AYUSH-pro-grammer/stm-flight-controller/bom.csv

Reference | Component | Quantity | Unit Price (USD) | Product Link
C1; C5 | YAGEO 10pF 0402 | 2 | 0.0213 | https://www.lcsc.com/product-detail/C3860506.html
C2 | CCTC 10uF 0805 | 1 | 0.0420 | https://www.lcsc.com/product-detail/C380331.html
C3; C7; C13; C23; C24; C28; C29 | FH 100nF 0603 | 7 | 0.0053 | https://www.lcsc.com/product-detail/C30926.html
C4; C6; C9; C11; C12; C17; C18; C19; C20; C21; C22 | FH 100nF 0603 | 11 | 0.0053 | https://www.lcsc.com/product-detail/C30926.html
C8; C10 | Samsung 2.2uF 0603 | 2 | 0.0120 | https://www.lcsc.com/product-detail/C23630.html
C14 | CCTC 10nF 0402 | 1 | 0.0057 | https://www.lcsc.com/product-detail/C688874.html
C15; C16 | SAMWHA 1uF 0603 | 2 | 0.0134 | https://www.lcsc.com/product-detail/C513775.html
C25; C26 | YAGEO 22uF 1210 | 2 | 0.5208 | https://www.lcsc.com/product-detail/C5341638.html
C27 | KEMET 220pF 0603 | 1 | 0.1150 | https://www.lcsc.com/product-detail/C3843887.html
C30 | Samsung Electro-Mechanics CL10A105KB8NNNC 1uF 50V 0603 | 1 | 0.0159 | https://www.lcsc.com/product-detail/C15849.html
C31 | YAGEO 4.7uF 0805 25V | 1 | 0.0717 | https://www.lcsc.com/product-detail/C5185457.html
C32 | FH 4.7uF 0805 25V | 1 | 0.0617 | https://www.lcsc.com/product-detail/C274413.html
C33 | CCTC 10nF 0603 | 1 | 0.0055 | https://www.lcsc.com/product-detail/C282516.html
C34 | FH 2.2nF 0603 | 1 | 0.0109 | https://www.lcsc.com/product-detail/C1604.html
C35 | YAGEO 22pF 0603 | 1 | 0.0295 | https://www.lcsc.com/product-detail/C2240294.html
C36 | YAGEO 10nF 0603 | 1 | 0.0151 | https://www.lcsc.com/product-detail/C100042.html
C37; C38 | CCTC 47uF 1210 | 2 | 0.2469 | https://www.lcsc.com/product-detail/C53327077.html
C39 | KEMET 100nF 0805 | 1 | 0.0207 | https://www.lcsc.com/product-detail/C141162.html
D1 | DIODES SD103ATW-7-F Schottky diode array - footprint check required | 1 | 0.2775 | https://www.lcsc.com/product-detail/C3758863.html
D2 | Hubei KENTO Blue LED 0603 | 1 | 0.0104 | https://www.lcsc.com/product-detail/C2288.html
D3; D6 | Yongyu Red LED 0603 | 2 | 0.0131 | https://www.lcsc.com/product-detail/C434419.html
D4 | Comchip SS54-HF | 1 | 1.0512 | https://www.lcsc.com/product-detail/C3757794.html
D5 | High Diode BAT54C | 1 | 0.0127 | https://www.lcsc.com/product-detail/C466637.html
FB1 | Murata BLM18PG121SN1D Ferrite Bead | 1 | 0.0153 | https://www.lcsc.com/product-detail/C14709.html
FB2; FB3 | TAI-TECH HCB1608KF-121T30 120R Ferrite Bead 0603 | 2 | 0.0087 | https://www.lcsc.com/product-detail/C353920.html
J1 | HMTCONN Micro-USB B SMD right-angle - footprint check required | 1 | 0.0704 | https://www.lcsc.com/product-detail/C53121380.html
J2; J4; J23; J17; J18; J19; J20; J21; J22; J24; J25; J26; J28 | BOOMELE 2.54mm 1x40P male header strip - cut to length | 2 | 0.1575 | https://www.lcsc.com/product-detail/C2337.html
J3 | Hirose DM3AT-SF-PEJM5 MicroSD Connector | 1 | 1.4048 | https://www.lcsc.com/product-detail/C114218.html
J29 | ronghe RH-5016 SMD Test Point (4.0x4.0mm pad) - footprint check required | 1 | 0.0926 | https://www.lcsc.com/product-detail/C5199799.html
L1 | KOHERelec MDA7030-4R7M 4.7uH | 1 | 0.6353 | https://www.lcsc.com/product-detail/C2847483.html
R1 | YAGEO 1k 0603 | 1 | 0.0053 | https://www.lcsc.com/product-detail/C22548.html
R2 | SEI 332k 1206 | 1 | 0.0145 | https://www.lcsc.com/product-detail/C2486051.html
R3; R4; R12; R19 | YAGEO 1.5k 0603 | 4 | 0.0033 | https://www.lcsc.com/product-detail/C114668.html
R5 | Vishay 10k 0805 | 1 | 0.0093 | https://www.lcsc.com/product-detail/C844937.html
R6; R7; R8; R9; R10; R11 | YAGEO 4.7k 0603 | 6 | 0.0032 | https://www.lcsc.com/product-detail/C99782.html
R15 | SEI 35.7k 1206 | 1 | 0.1044 | https://www.lcsc.com/product-detail/C2533888.html
R16 | YAGEO 0 ohm 0603 | 1 | 0.0021 | https://www.lcsc.com/product-detail/C95177.html
R17 | TE Connectivity 10.5k 1206 | 1 | 0.2813 | https://www.lcsc.com/product-detail/C2084092.html
R18 | YAGEO RT0603BRD073K2L 3.2k 0603 | 1 | 0.0371 | https://www.lcsc.com/product-detail/C861375.html
SW1 | C&K PCM12 SPDT Slide Switch | 1 | 1.2754 | https://www.lcsc.com/product-detail/C221841.html
SW2 | C&K PTS647 Tactile Switch | 1 | 0.2704 | https://www.lcsc.com/product-detail/C2800043.html
U1 | TDK InvenSense MPU-6050 | 1 | 20.2250 | https://www.lcsc.com/product-detail/C24112.html
U2 | ST STM32F405RGT6 | 1 | 6.9460 | https://www.lcsc.com/product-detail/C15742.html
U3 | AMS1117-3.3 | 1 | 0.2093 | https://www.lcsc.com/product-detail/C6186.html
U4 | ST LIS3MDLTR | 1 | 3.7855 | https://www.lcsc.com/product-detail/C478483.html
U5 | Bosch BMP280 Digital Pressure Sensor | 1 | 8.3900 | https://robu.in/product/bosch-bmp280-digital-pressure-sensor/
U6 | TI TPS5431DDA | 1 | 3.7620 | https://www.lcsc.com/product-detail/C1355446.html
U7 | ST USBLC6-2SC6 | 1 | 0.1786 | https://www.lcsc.com/product-detail/C7519.html
Y1 | DIODES FY1600066 16MHz Crystal | 1 | 1.0077 | https://www.lcsc.com/product-detail/C5717615.html
PCB | PCB | 1 | 8.0000 | https://jlcpcb.com
TOTAL | All items + PCB subtotal |  | 60.5830
