AYUSH-pro-grammer/stm-flight-controller/kicad/flight-controller-v2-mine.kicad_pcb

## KiCad design kicad/flight-controller-v2-mine.kicad_pcb (2026-10-30)

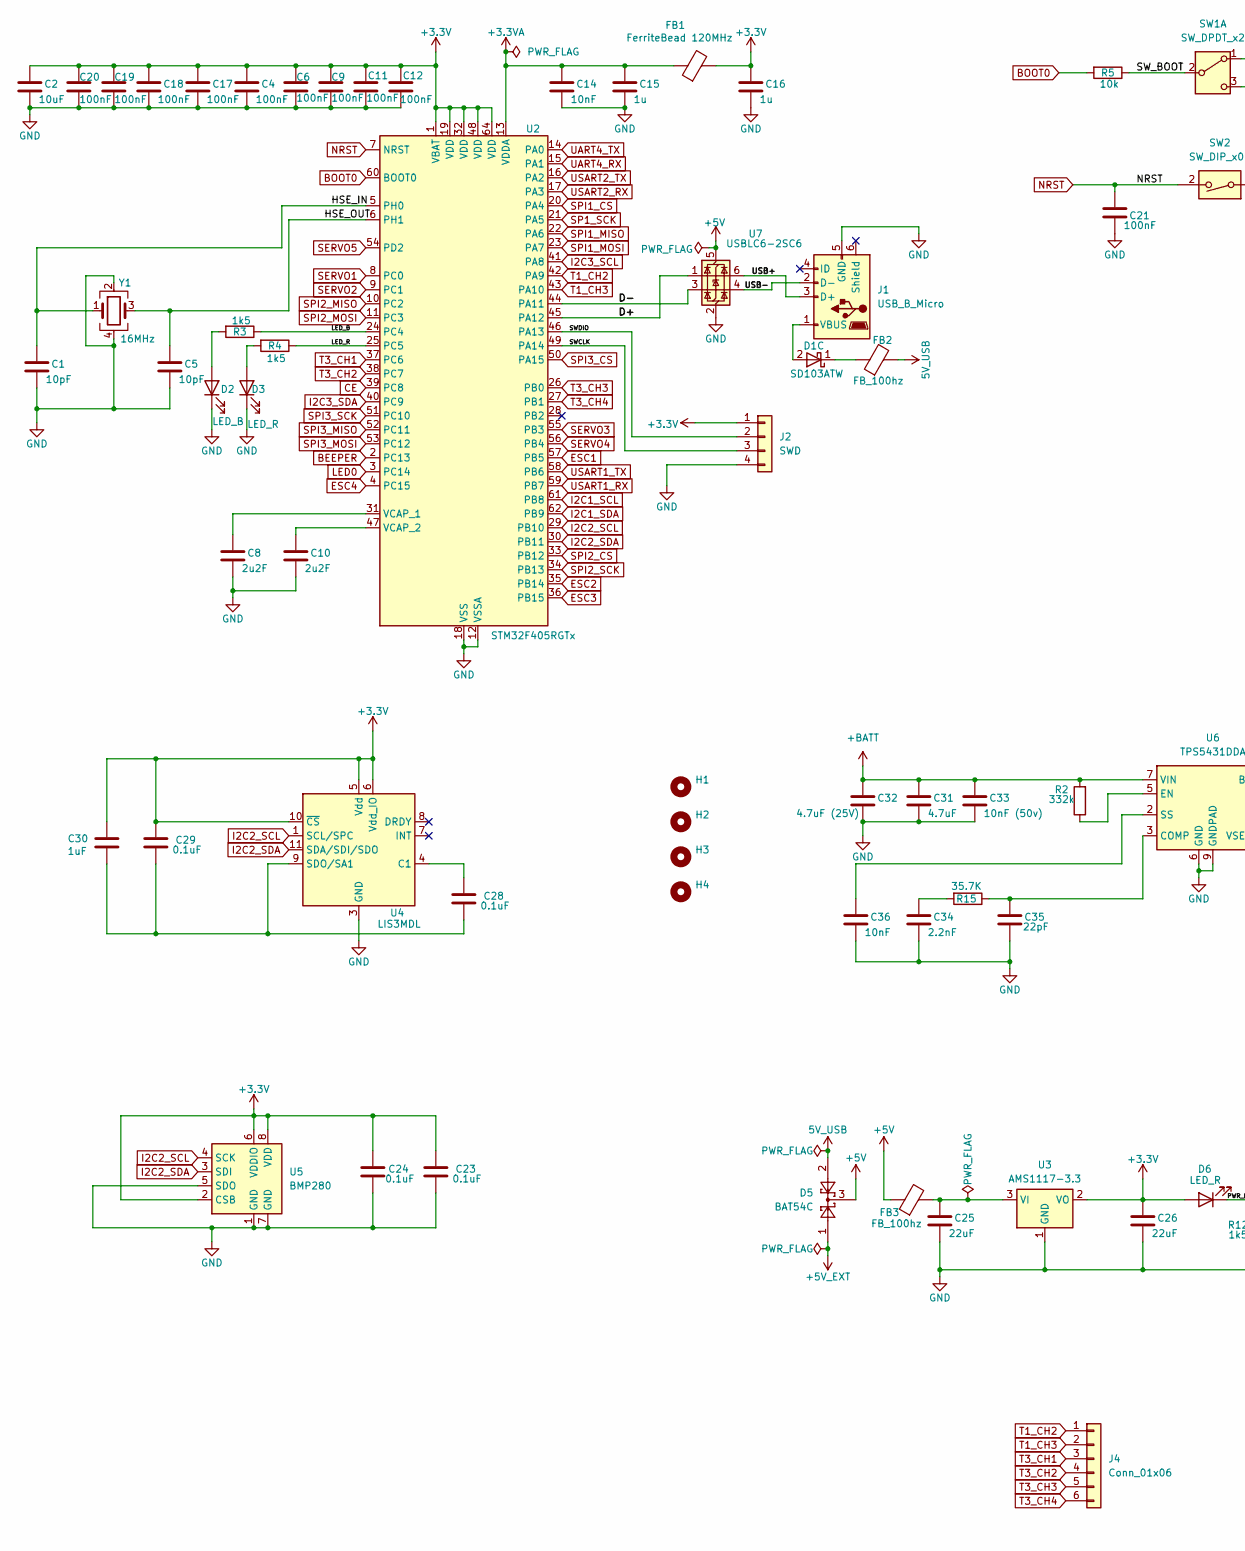
[picture p5: schematic flight-controller-v2-mine.kicad_sch, part in row 1, column 1]

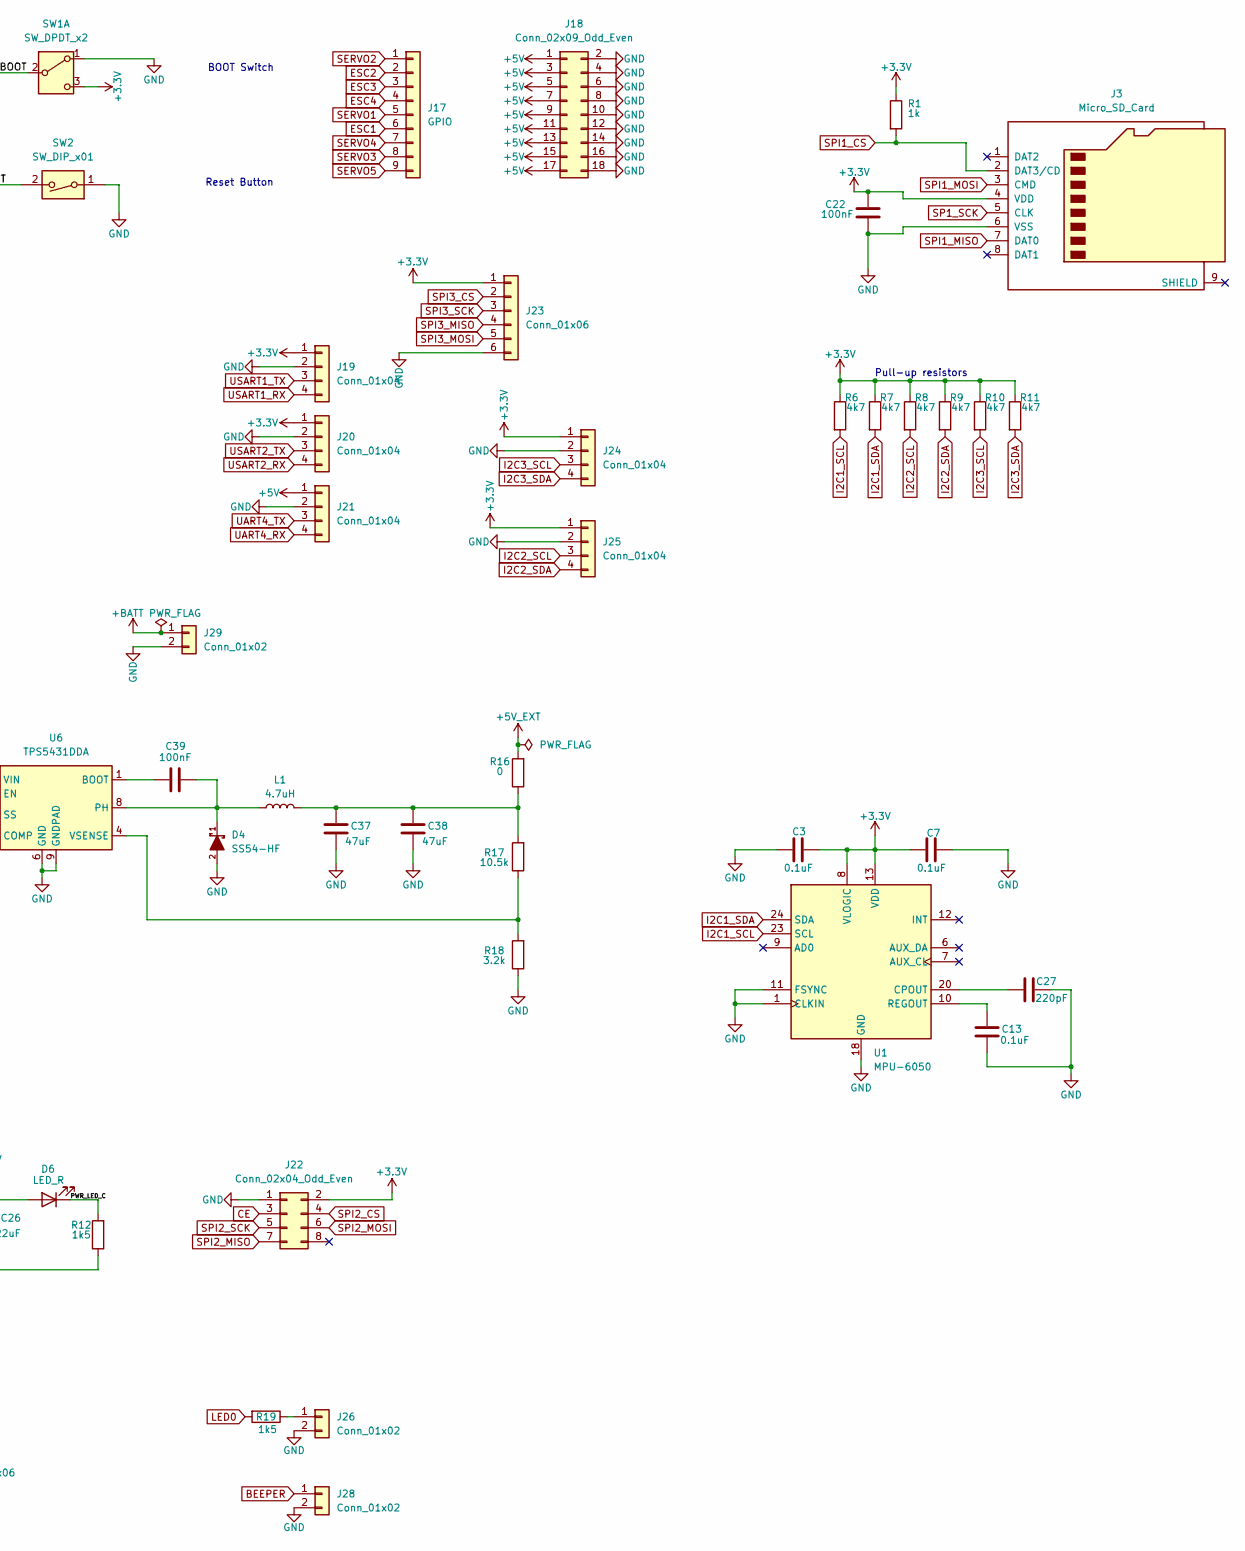
[picture p6: schematic flight-controller-v2-mine.kicad_sch, part in row 1, column 2]

Parts:
C1, C5: 10pF; C_0402_1005Metric
C2: 10uF; C_0805_2012Metric
C3, C7, C13, C23, C24, C28, C29: 0.1uF; C_0603_1608Metric
C4, C6, C9, C11, C12, C17, C18, C19, C20, C21, C22: 100nF; C_0603_1608Metric
C8, C10: 2u2F; C_0603_1608Metric
C14: 10nF; C_0402_1005Metric
C15, C16: 1u; C_0603_1608Metric
C25, C26: 22uF; C_1210_3225Metric
C27: 220pF; C_0603_1608Metric
C30: 1uF; C_0603_1608Metric
C31: 4.7uF; C_0805_2012Metric
C32: 4.7uF (25V); C_0805_2012Metric
C33: 10nF (50v); C_0603_1608Metric
C34: 2.2nF; C_0603_1608Metric
C35: 22pF; C_0603_1608Metric
C36: 10nF; C_0603_1608Metric
C37, C38: 47uF; C_1210_3225Metric
C39: 100nF; C_0805_2012Metric
D1: SD103ATW; D_SOD-123
D2: LED_B; LED_0603_1608Metric
D3, D6: LED_R; LED_0603_1608Metric
D4: SS54-HF; D_SMA; MOUSER_PART_NUMBER 750-SS54-HF
D5: BAT54C; SOT-23
FB1: FerriteBead 120MHz; L_0603_1608Metric
FB2, FB3: FB_100hz; L_0603_1608Metric
H1, H2, H3, H4: MountingHole; MountingHole_4.3mm_M4_Pad_Via
J1: USB_B_Micro; USB_Mini-B_Lumberg_2486_01_Horizontal
J2: SWD; PinHeader_1x04_P2.54mm_Vertical
J3: Micro_SD_Card; microSD_HC_Hirose_DM3AT-SF-PEJM5
J4, J23: Conn_01x06; PinHeader_1x06_P2.54mm_Vertical
J17: GPIO; PinHeader_1x09_P2.54mm_Vertical
J18: Conn_02x09_Odd_Even; PinHeader_2x09_P2.54mm_Vertical
J19, J20, J21, J24, J25: Conn_01x04; PinHeader_1x04_P2.54mm_Vertical
J22: Conn_02x04_Odd_Even; PinHeader_2x04_P2.54mm_Vertical
J26, J28: Conn_01x02; PinHeader_1x02_P2.54mm_Vertical
J29: Conn_01x02; TestPoint_Pad_4.0x4.0mm
L1: 4.7uH; L_KOHERelec_MDA7030
R1: 1k; R_0603_1608Metric
R2: 332k; R_1206_3216Metric
R3, R4, R12, R19: 1k5; R_0603_1608Metric
R5: 10k; R_0805_2012Metric
R6, R7, R8, R9, R10, R11: 4k7; R_0603_1608Metric
R15: 35.7K; R_1206_3216Metric
R16: 0; R_0603_1608Metric
R17: 10.5k; R_1206_3216Metric
R18: 3.2k; R_0603_1608Metric
SW1: SW_DPDT_x2; SW_SPDT_PCM12
SW2: SW_DIP_x01; SW_SPST_PTS647_Sx38
U1: MPU-6050; InvenSense_QFN-24_4x4mm_P0.5mm
U2: STM32F405RGTx; LQFP-64_10x10mm_P0.5mm
U3: AMS1117-3.3; SOT-223-3_TabPin2
U4: LIS3MDL; LGA-12_2x2mm_P0.5mm
U5: BMP280; Bosch_LGA-8_2x2.5mm_P0.65mm_ClockwisePinNumbering
U6: TPS5431DDA; TI_SO-PowerPAD-8_ThermalVias
U7: USBLC6-2SC6; SOT-23-6
Y1: 16MHz; Crystal_SMD_5032-4Pin_5.0x3.2mm

Connections:
5V_USB: D5.2, FB2.2
+3.3V: C2.1, C3.2, C4.1, C6.1, C7.1, C9.1, C11.1, C12.1, C16.1, C17.1, C18.1, C19.1, C20.1, C22.1, C23.2, C24.2, C26.1, C29.2, C30.2, D6.2 (A), FB1.2, J2.1, J3.4 (VDD), J19.1, J20.1, J22.2, J23.1, J24.1, J25.1, R1.1, R6.1, R7.1, R8.1, R9.1, R10.1, R11.1, SW1.3 (C), U1.8 (VLOGIC), U1.13 (VDD), U2.1 (VBAT), U2.19 (VDD), U2.32 (VDD), U2.48 (VDD), U2.64 (VDD), U3.2 (VO), U4.5 (Vdd), U4.6 (Vdd_IO), U4.10 (~CS), U5.2 (CSB), U5.6 (VDDIO), U5.8 (VDD)
+3.3VA: C14.1, C15.1, FB1.1, U2.13 (VDDA)
+5V: D5.3, FB3.1, J18.1, J18.3, J18.5, J18.7, J18.9, J18.11, J18.13, J18.15, J18.17, J21.1, U7.5 (VBUS)
+5V_EXT: D5.1, R16.2
+BATT: C31.1, C32.1, C33.1, J29.1, R2.2, U6.7 (VIN)
/D+: U2.45 (PA12), U7.1 (I/O1)
/D-: U2.44 (PA11), U7.3 (I/O2)
/HSE_IN: C1.1, U2.5 (PH0), Y1.1
/HSE_OUT: C5.1, U2.6 (PH1), Y1.3
/LED_B: R3.1, U2.24 (PC4)
/LED_R: R4.1, U2.25 (PC5)
/SWCLK: J2.3, U2.49 (PA14)
/SWDIO: J2.2, U2.46 (PA13)
/SW_BOOT: R5.1, SW1.2 (B)
/USB+: J1.3 (D+), U7.6 (I/O1)
/USB-: J1.2 (D-), U7.4 (I/O2)
/power and connectors/PWR_LED_C: D6.1 (K), R12.2
BEEPER: J28.1, U2.2 (PC13)
BOOT0: R5.2, U2.60 (BOOT0)
CE: J22.3, U2.39 (PC8)
ESC1: J17.6, U2.57 (PB5)
ESC2: J17.2, U2.35 (PB14)
ESC3: J17.3, U2.36 (PB15)
ESC4: J17.4, U2.4 (PC15)
GND: C1.2, C2.2, C3.1, C4.2, C5.2, C6.2, C7.2, C8.2, C9.2, C10.2, C11.2, C12.2, C13.2, C14.2, C15.2, C16.2, C17.2, C18.2, C19.2, C20.2, C21.2, C22.2, C23.1, C24.1, C25.2, C26.2, C27.2, C31.2, C32.2, C33.2, C34.2, C35.2, C36.2, C37.2, C38.2, D2.1 (K), D3.1 (K), D4.2, J1.5 (GND), J2.4, J3.6 (VSS), J18.2, J18.4, J18.6, J18.8, J18.10, J18.12, J18.14, J18.16, J18.18, J19.2, J20.2, J21.2, J22.1, J23.6, J24.2, J25.2, J26.2, J28.2, J29.2, R12.1, R18.1, SW1.1 (A), SW2.1, U1.1 (CLKIN), U1.11 (FSYNC), U1.18 (GND), U2.12 (VSSA), U2.18 (VSS), U3.1 (GND), U4.3 (GND), U5.1 (GND), U5.5 (SDO), U5.7 (GND), U6.6 (GND), U6.9 (GNDPAD), U7.2 (GND), Y1.2, Y1.4
I2C1_SCL: R6.2, U1.23 (SCL), U2.61 (PB8)
I2C1_SDA: R7.2, U1.24 (SDA), U2.62 (PB9)
I2C2_SCL: J25.3, R8.2, U2.29 (PB10), U4.1 (SCL/SPC), U5.4 (SCK)
I2C2_SDA: J25.4, R9.2, U2.30 (PB11), U4.11 (SDA/SDI/SDO), U5.3 (SDI)
I2C3_SCL: J24.3, R10.2, U2.41 (PA8)
I2C3_SDA: J24.4, R11.2, U2.40 (PC9)
LED0: R19.2, U2.3 (PC14)
NRST: C21.1, SW2.2, U2.7 (NRST)
unnamed: C34.1, R15.2
unnamed: C37.1, C38.1, L1.2, R16.1, R17.2
unnamed: D1.2 (A), J1.1 (VBUS)
unnamed: D1.1 (K), FB2.1
unnamed: D2.2 (A), R3.2
unnamed: D3.2 (A), R4.2
unnamed: J26.1, R19.1
unnamed: C27.1, U1.20 (CPOUT)
unnamed: C13.1, U1.10 (REGOUT)
unnamed: C8.1, U2.31 (VCAP_1)
unnamed: C10.1, U2.47 (VCAP_2)
unnamed: C25.1, FB3.2, U3.3 (VI)
unnamed: C28.2, U4.4 (C1)
unnamed: C28.1, C29.1, C30.1, U4.9 (SDO/SA1)
unnamed: C39.1, U6.1 (BOOT)
unnamed: C35.1, R15.1, U6.3 (COMP)
unnamed: R2.1, U6.5 (EN)
unnamed: C39.2, D4.1, L1.1, U6.8 (PH)
unnamed: C36.1, U6.2 (SS)
unnamed: R17.1, R18.2, U6.4 (VSENSE)
SERVO1: J17.5, U2.8 (PC0)
SERVO2: J17.1, U2.9 (PC1)
SERVO3: J17.8, U2.55 (PB3)
SERVO4: J17.7, U2.56 (PB4)
SERVO5: J17.9, U2.54 (PD2)
SP1_SCK: J3.5 (CLK), U2.21 (PA5)
SPI1_CS: J3.2 (DAT3/CD), R1.2, U2.20 (PA4)
SPI1_MISO: J3.7 (DAT0), U2.22 (PA6)
SPI1_MOSI: J3.3 (CMD), U2.23 (PA7)
SPI2_CS: J22.4, U2.33 (PB12)
SPI2_MISO: J22.7, U2.10 (PC2)
SPI2_MOSI: J22.6, U2.11 (PC3)
SPI2_SCK: J22.5, U2.34 (PB13)
SPI3_CS: J23.2, U2.50 (PA15)
SPI3_MISO: J23.4, U2.52 (PC11)
SPI3_MOSI: J23.5, U2.53 (PC12)
SPI3_SCK: J23.3, U2.51 (PC10)
T1_CH2: J4.1, U2.42 (PA9)
T1_CH3: J4.2, U2.43 (PA10)
T3_CH1: J4.3, U2.37 (PC6)
T3_CH2: J4.4, U2.38 (PC7)
T3_CH3: J4.5, U2.26 (PB0)
T3_CH4: J4.6, U2.27 (PB1)
UART4_RX: J21.4, U2.15 (PA1)
UART4_TX: J21.3, U2.14 (PA0)
USART1_RX: J19.4, U2.59 (PB7)
USART1_TX: J19.3, U2.58 (PB6)
USART2_RX: J20.4, U2.17 (PA3)
USART2_TX: J20.3, U2.16 (PA2)

Notes on the sheet:
Reset Button
Pull-up resistors
BOOT Switch

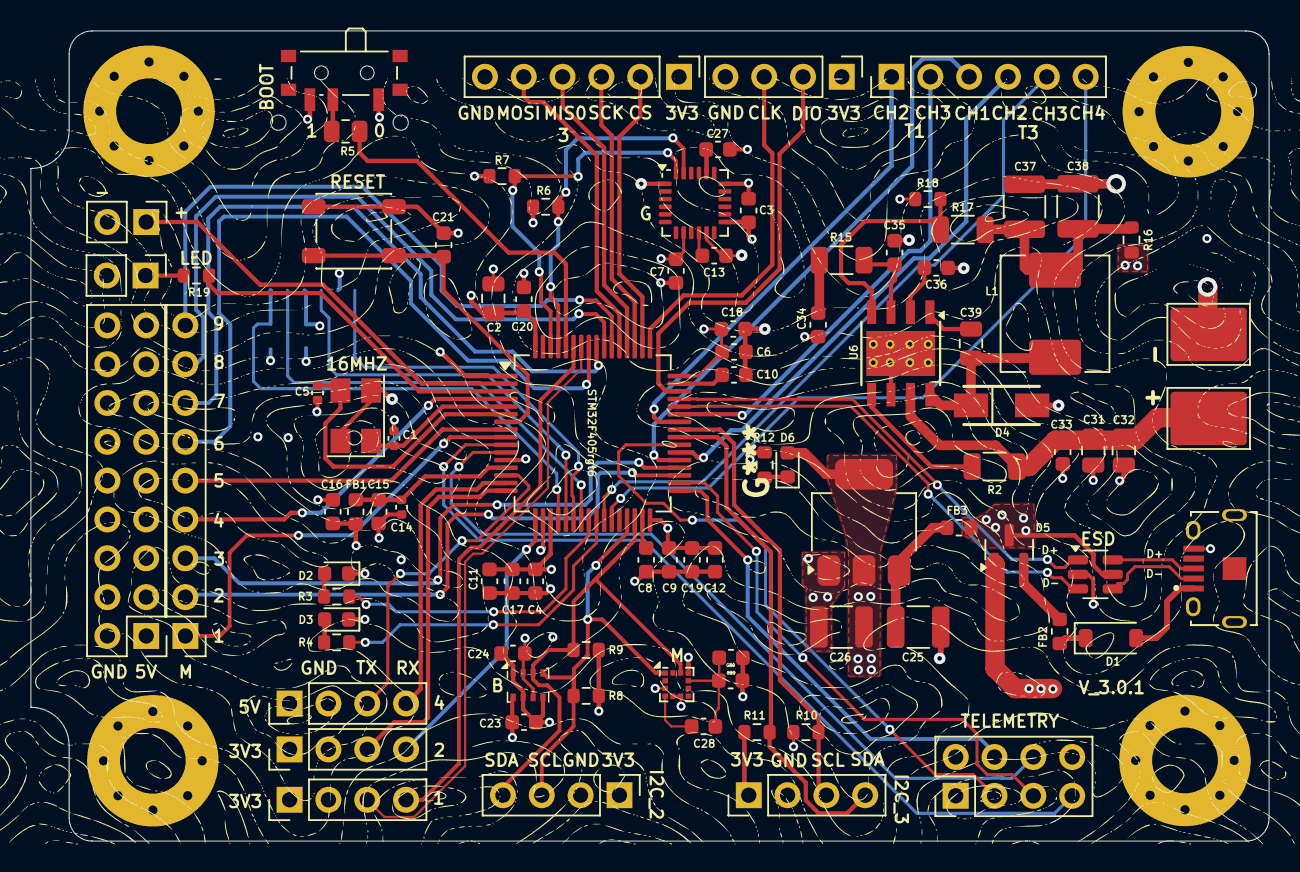
[picture p7: board flight-controller-v2-mine.kicad_pcb from above]

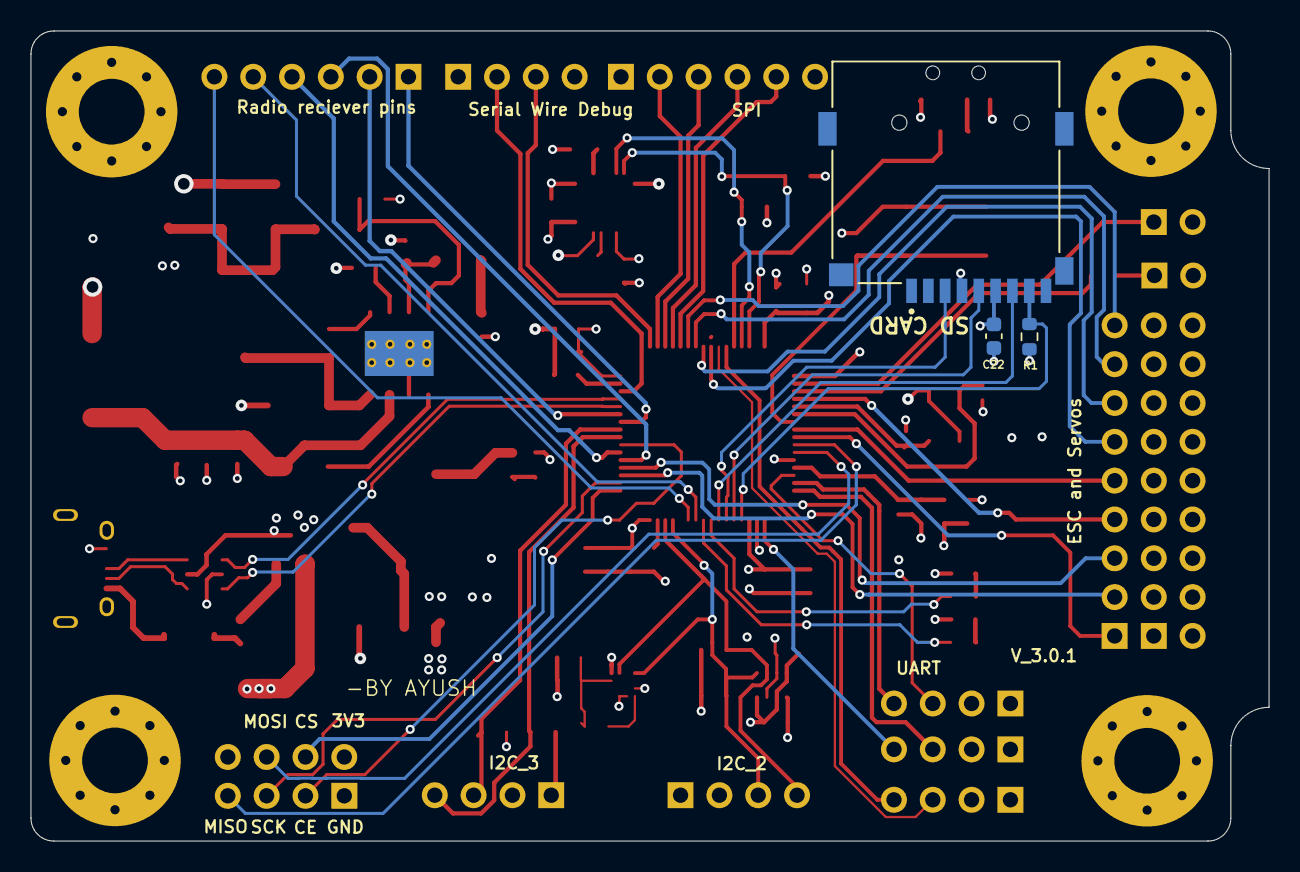
[picture p8: board flight-controller-v2-mine.kicad_pcb from below]

Board: 4 copper layers, 81.0 x 53.0 mm, 96 parts (3 on the bottom side), 83 nets.
